pao62/Q-alice/doc/firmware.md

# ファームウェア
## ①QMK Toolboxのダウンロード
ファームウェアの書き込みはQMK Toolboxを用いて行います。https://github.com/qmk/qmk_toolbox/releases/ から最新版のQMK Toolboxをダウンロードしてください。 
## ②ファームウェアの書き込み
下記URLから書き込み用のファームウェアをダウンロードしてください。 \
[qalice.hex](https://cdn.discordapp.com/attachments/1122727576599797861/1130076679038046349/qalice_via.hex) \
ダウンロードが完了したら、QMK Toolboxを起動し、「Open」から先ほどダウンロードしたファイルを選択します。その後、「Auto-Flash」のチェックボックスにチェックを入れ、基板に取り付けてあるリセットスイッチを押せばファームウェアが書き込まれます。 \

# キーマップの変更
Q-aliceはviaを用いてキーマップの変更を行います。viaはhttps://usevia.app/settings からアクセスしてください。　\
[qalice.json](https://cdn.discordapp.com/attachments/1122727576599797861/1130076737741529158/qalice.json)からjsonファイルをダウンロードし、viaのsettingの欄で読み込ませてください。 \
viaでのキーマップの変更方法は僕なんかより、わかりやすくまとめているサイトがあるのでそちらを見ていただければ幸いかと。
