pao62/Q-alice/doc/buildguide.md

# 初めに

Q-aliceのお買い上げありがとうございます。設計者のぱおと申します。こちらは基本セットを購入された方向けのビルドガイドになります。 \
まず初めにキットに含まれているものの確認をお願いします。

| 名前 | 数 | 
|:-|:-|
| メイン基板 | １枚 |
| スイッチプレート | １枚 |
| ボトムプレート | １枚 |
| カバープレート | １枚 |
| pro micro | １枚　|
| 2uスタビライザー　| ３個 |
| ロータリーエンコーダ | １個 |
| リセットスイッチ | １個 |
| smdダイオード | ６４個＋予備 |
| PCBソケット | ６３個＋予備　|
| m.2　ネジ　4mm | ２０本　|
| m.2　スペーサー 7mm | １０個 |
| m.2 スペーサー（オスメス） 4mm | ６個 |
| ゴム足 | ８個 |

ご自身で用意していただくもの \
・MX互換キースイッチ×63 \
・MX互換キーキャップ一式 \
・（オプション）ロータリーエンコーダ用ノブ 

基板の表と裏がわかりやすいように、表側にマスキングテープを張ることをお勧めします。 \
上の写真が表、下の写真が裏です。 \



# 組み立て

## ①ダイオードの取り付け
**ダイオードは取り付ける向きが決まっています**。ダイオードに書かれている「|」のマークが基板に書かれている「|◁」のマークの「|」に合う向きにして取り付けを行います。 \
まず、基板側に予備はんだを盛りつけます。見にくいかもしれませんが、右側に予備はんだが盛り付けてあります。 \
 \
予備はんだが終わったら、ダイオード本体はかなり小さいのでピンセットを用いてダイオードを持ち、もう一方の手ではんだごてを持って、予備はんだを溶かしつつダイオード本体を取り付けます。もう一度言いますが、**必ず向きを確認してください。**　\
 \
最後にダイオードのはんだ付けされていない側の足もはんだ付けしてダイオードのはんだ付けは終了です。

## ②リセットスイッチの取り付け
リセットスイッチを**基板の裏側**に取り付けます。かならず裏であることを確認してください。　\
図のようにリセットスイッチの足が飛び出てしまうのでニッパーを用いて切り取ります。 \
　\
 \

## ③pro microの取り付け
pro microもリセットスイッチと同様、**基板の裏側**に取り付けます。 \
まず初めにピンヘッダを基板側に取り付けます。pro microをマスキングテープで仮止めしておくことをおすすめします。まず基板の表側に飛び出ている足をニッパーを用いて切り取り、その後はんだ付けを行います。　\
　\
 \
次に、基板の裏側、pro microから飛び出ている足を切り取り、はんだ付けを行います。 \
 \

## ④ファームウェアの書き込み
ここでファームウェアを書き込む必要はありませんが、うまく動作しない場合この段階であれば原因究明がまだ容易なので、ここで動作確認をしておくことをおすすめします。ファームウェアの書き込みについては https://github.com/pao62/Q-alice/blob/main/doc/firmware.md を参照ください。 \
ファームウェアの書き込みが終わったら、ピンセットなどを用いてPCBソケットを取り付けるパットをショートさせて動作確認を行うことをおすすめします。

## ⑤PCBソケットの取り付け
PCBソケットを基板の裏側に取り付けます。基板に書かれているマークに合わせてソケットを置いてはんだ付けを行ってください。　\
ここまで順番通りにやっていれば、下の写真のようになっているはずです。 \


## ⑥ロータリーエンコーダの取り付け
ロータリーエンコーダを基板の表側の中央に取り付けます。ロータリーエンコーダの足が基板に合うように取り付け、リセットスイッチやピンヘッダと同様に飛び出た足を切り取ります。 \
 \
 

## ⑦スイッチプレートの取り付け
まず初めにスタビライザーを3か所に取り付けます。写真のように金属の棒が下側に来るように取り付け、しっかりと穴にはめてください。また、スタビライザーはかなりガチャガチャ音が鳴るため潤滑油を塗っておくことをおすすめします。 \

次に、スイッチプレートの角にのみキースイッチを取り付け、基板のソケットに合うようにスイッチプレートを取り付けてください。そしたら残りの穴すべてにもキースイッチを取り付けてください。 \


## ⑧ボトムプレートの取り付け
ボトムプレートを取り付ける前に、スイッチプレートにスペーサーを取り付けます。10個取り付ける場所があるので、7mmのスペーサーを取り付けてください。\
 \
その後、ボトムプレートをのせ、下２個の穴にネジを取り付け、上側の6個の穴にはスペーサー（オスメス）　4mmを取り付けてください。　\


## ⑨カバープレートの取り付け
カバープレートを、「cover」の文字が見えなくなるように取り付けてください。その後、カバープレートの上からネジを６個取り付けてください。　\


## ⑩ゴム足の取り付け
８個あるゴム足をお好きな場所に貼り付けてください。 \

## ⑪キーキャップの取り付け
最後にお好きなキーキャップやロータリーエンコーダのノブを取り付けて完成です。お疲れさまでした。　\
